f18c052f/smart-trashbox-trial/docs/inherited/hardware.md

# 手元にある部品と機材

> 旧リポジトリの部品表は「構成部品の表」であって、買ったかどうかは管理していなかった。
> 2026-09 時点で、足回りの部品と電子部品はすべて手元にあると記録されている。
> 念のため、トライアルを始める前に現物と照らし合わせること。
>
> 数値はメーカー資料・商品仕様・データシートの値である。
> 旧リポジトリで採寸した値は参考値として [reference-measurements.md](./reference-measurements.md) に分けて置いた。

## 1. 固定側

| 部品 | 型番・仕様 | 数量 | メモ |
|---|---|---|---|
| 深度カメラ | Intel **RealSense D435** | 1 | グローバルシャッターで速く動く物に強い。IMU は無い（カメラを固定するので不要） |
| 計算機 | **Raspberry Pi 4 Model B（4GB）** | 1 | セットアップ済み。→ [dev-environment.md](./dev-environment.md#3-raspberry-pi-4) |

## 2. 移動体: 駆動

| 部品 | 型番・仕様 | 数量 | メモ |
|---|---|---|---|
| ギアモータ | TOPINCN **JGB37-520** 12V / 530RPM / エンコーダ付き | 3 | 下の表 |
| モータブラケット | モータに付いてきた金属ブラケット | 3 | 別途買わなくてよい |
| オムニホイール | 60mm ダブルオムニ（Nexus **14145 相当品**） | 3 | **純正 Nexus 品ではない**。下の表 |
| ホイールハブ | 6mm ハブ（Nexus **18020**。純正か相当品かは未確認） | 3 | 下の表 |
| モータドライバ | 秋月電子 **AE-TB67H450**（東芝 TB67H450FNG） | 3 | モータ1個に1台 |
| MCU | **ESP32 DevKit（classic ESP32 / ESP32-WROOM-32）** | 2 | チップの刻印で classic ESP32 と確認済み。1台は予備（固定側で中継に使う案もある） |

### JGB37-520（商品仕様）

| 項目 | 値 |
|---|---|
| 電圧 | DC 12V |
| 無負荷回転数 / 定格回転数 | 530 RPM / 約 407 RPM |
| 減速比 | 約 19:1（公称。実際は割り切れない比のことが多い） |
| 定格トルク / 最大トルク | 約 2.2 / 約 3.1 kgf·cm |
| ストール電流 | 約 2.3 A |
| シャフト | 6mm D カット、長さ約 15.5mm |
| エンコーダ | ホール式、電源 3.3V / 5V、11 パルス/モータ1回転。出力軸1回転あたり約 209（11 × 約19）。**実際の値はカウント方法で変わるので測って決める** |
| 線 | 6本。赤・白 = モータ電源、青 = エンコーダ VCC、黒 = エンコーダ GND、黄・緑 = A相/B相（どちらが A 相かは仕様に書かれていない） |

⚠️ **黒はエンコーダの GND で、モータ電源の − は白である。**「黒＝GND」と思ってモータ電源を青・黒へ入れると、
エンコーダが壊れる。通電の前にテスターで系統を確かめる（→ [circuit-bringup.md](./circuit-bringup.md) の E-0）。

60mm ホイールでの理論周速: 無負荷 530RPM で約 1.66 m/s、定格 407RPM で約 1.28 m/s。
負荷・スリップ・電圧降下で実際はこれより遅くなる。

### オムニホイール（メーカー図面の値）

| 項目 | 値 |
|---|---|
| 外径 / 幅 | Ø60 / 25.6mm（**相当品なので現物は図面と違う**。旧リポジトリでの採寸は Ø57.9 / 23.4mm → [参考値](./reference-measurements.md#1-オムニホイールnexus-14145-相当品)） |
| 中心穴 | Ø12.5mm（ハブのボスを受ける穴。シャフトに直接は付かない） |
| ボルト円 | Ø21 と Ø28。取付穴 5-Ø3.2 / 6-Ø3（ハブと合うのは Ø21 側の 6-Ø3 を 120° おきに3本） |
| ローラー | 1枚に5個 × 2枚 = 10個、ナイロン / PE |
| 重さ / 耐荷重 | 80g / 3kg（1輪あたり） |

### ハブ（メーカー資料の値）

| 項目 | 値 |
|---|---|
| 内径 | Ø6、**真円**（D 形でもキー溝付きでもない） |
| フランジ外径 / 厚さ | Ø28 / 4mm |
| ボス | Ø12 × 12mm |
| 全長 | 16mm（シャフト 15.5mm とほぼ同じ長さなので、軸方向の調整代は無い） |
| ボルト円 | Ø21、3-Ø3.2 |
| 止めネジ | M4 × 1 |
| 重さ | 12g |

**つながり方**: モータの 6mm D シャフト → ハブ（加工なしで付く）→ ボスをホイールの Ø12.5 の穴へ入れてボルト円でネジ止め。
この組み合わせで組めることは現物で確認済み。

⚠️ **トルクを伝えるのは M4 のイモネジ1本だけ。** ハブの穴は真円なので、イモネジがシャフトの D カットの
平らな面に当たっていれば保持でき、丸い面に当たっていると滑る。
**滑ってもエンコーダはモータ側で回り続けるので、制御からは気付けない。** 組むときに平面へ当てる。

### AE-TB67H450（データシート・アプリケーションノートより）

| 項目 | 値 |
|---|---|
| 入力 | IN1 / IN2。H レベル 2.0〜5.5V なので ESP32 の 3.3V で動く。**内部に 100kΩ のプルダウンがある** |
| 真理値表 | (IN1, IN2) = (L, L) ストップ / (H, L) 正転 / (L, H) 逆転 / (H, H) ブレーキ |
| 論理電源 | 別のピンは無い（VM から内部で作る） |
| 端子 | 8本: GND / IN2 / IN1 / VREF / VM / OUT1 / RS / OUT2 |
| 過電流保護（ISD） | 標準 4.9A でラッチ。電源の入れ直しか、IN1/IN2 を 1ms 以上 L にしてから再指令で解除 |
| 熱 | 許容損失 2.85W（4層基板での値）。ストール 2.3A を流し続けると約 3.2W で超える |
| センス抵抗 | **モジュールには付いていない**（テスターで確認済み）。旧設計では付けないことにした（→ [circuit.md](./circuit.md#4-電流の守り)） |

ストール電流 2.3A はこのドライバの能力に近い。モータを長くストールさせないことをソフトの保護で担保する前提で選んだ。

## 3. 移動体: 電源と回路部品

| 部品 | 型番・仕様 | 数量 | メモ |
|---|---|---|---|
| バッテリ | BTLIPO **1500mAh 3S 35C XT60**（商品コード `BTLIPO1500mA3S35CXT60*C`） | 1 | 公称 11.1V / 満充電 12.6V |
| 充電器 | G-FORCE **G3 CHARGER**（G0018） | 1 | LiPo 1〜3S のバランス充電。1500mAh なら 1.5A 設定で約 1C |
| 電源コネクタ | **XT60M**（車体側） | 1 | |
| メインヒューズ | **10A** ＋ ヒューズホルダ | 1 | バッテリの XT60 のすぐ後ろ |
| 5V 電源 | ROHM **BP5293-50** | 1 | 入力 7〜26V、出力 5V ±3% / 最大 1A、SIP3 |
| 電解コンデンサ | Rubycon **ZLH 1000µF / 35V** | 2 | ドライバの近く |
| セラミックコンデンサ | **0.1µF / 50V X7R** | 一式 | モータ端子、ドライバの VM と VREF、ADC 入力 |
| 抵抗 | **100kΩ 1%** / **27kΩ 1%** | 一式 | バッテリ電圧を測る分圧 |
| 電源配線 | 14AWG など | 一式 | |
| ユニバーサル基板 | 秋月 **C タイプ 72 × 47.5mm**、片面 | 1 | 片面なので裏で配線を回せない |
| 配線の固定 | 布テープ、結束バンド | 一式 | |

**決まっていないもの**: メイン電源スイッチ（付けるか、どこに付けるか）、3台のドライバへ電源を分ける端子（要るか、どう分けるか）、
M3 ネジ・ナット・熱圧入インサートの数と長さ。

**注意**

- 1500mAh は容量であって、流せる最大電流ではない。35C から計算した 52.5A を実際に使える上限と考えない。
- 10A ヒューズは短絡や配線事故から LiPo と配線を守るもの。モータ1個のストール（約2.3A）では切れない。
  ストール 2.3A × 3 ≒ 6.9A に制御回路の分が乗るので、5A では急加速で切れるおそれがある。
- 充電器のバランス端子は JST-XH の想定。バッテリ側の形は現物で確かめる。

## 4. ゴミ箱

| 項目 | 内容 |
|---|---|
| 品名 | キャンドゥ「ダストボックス丸」＝ **山田化学 No.335**（JAN 4965534335027） |
| 仕様 | 丸型、PP、6.9L、フタなし、110円 |
| 買い直し | アスクルなどの通販で単品約160円。100円ショップは在庫が入れ替わると同じ品が手に入らなくなるので、こちらが当てになる |

⚠️ **パッケージの寸法表記（φ220 × H224）は実物と合わない。** φ220 は開口の外径である。旧リポジトリでの採寸値は [reference-measurements.md](./reference-measurements.md#4-ゴミ箱山田化学-no335) にある（参考値）。

選んだ基準（実店舗の品揃えを調べて決めた）:

- 丸型であること。角形は方向によって開口の広さが変わる。
- 開口の内径 φ200 以上。100円ショップの丸型は φ215〜225 あたりが上限で、φ240 以上は見つからなかった。
- 300g 以下。軽さが欲しいのは転倒対策ではなく加速のため。
- 高さ 200〜300mm（寝かせた空き缶が収まる深さ）。
- 脚付き・丸底は不可。ほぼ全品に入れ子用のテーパーがあるので、テーパーの緩いものを選ぶ。
- フタ・スイング・内枠は開口を狭めるので、無いものを選ぶ。
- 5L〜7L が狙い目。それより大きくしても径はほとんど変わらず、高さだけ伸びる。

## 5. 開発・検証用の機材

| 機材 | 状態 | 用途 |
|---|---|---|
| 3Dプリンタ **Bambu Lab A1 mini** | 手元にある | 造形範囲 180 × 180 × 180mm。囲いが無いので、使える材料は PETG までと考える |
| 開発用PC（Windows 11 + WSL2） | 手元にある | → [dev-environment.md](./dev-environment.md) |
| SONY **DualSense**（PS5 コントローラ） | 手元にある | 手動で走らせる（テレオペ）ため |
| テスター | 手元にある | 配線色の確認・電圧測定・ADC の校正 |
| ノギス | 手元にある | 採寸 |
| **安定化電源**（電流制限つき、12V / 3A 以上） | **手元にあるか要確認** | 最初の通電は必ずこれで行う。LiPo では初通電しない |
| 可変抵抗（10kΩ B カーブ程度） | **手元にあるか要確認** | 机上でモータ出力を連続的に変えて確かめる |
| LED 2色・抵抗 1kΩ | 用意する | モータの代わりにドライバ出力へ付ける治具（→ [circuit-bringup.md](./circuit-bringup.md#led-治具)） |

**まだ買わないもの**（要るかどうか確かめてから買う）: ゴミ箱内側の緩衝材、非常停止用の部品、
Raspberry Pi 5 / Jetson などの上位の計算機（Pi 4 で足りないと測って分かったときだけ考える）。
