f18c052f/smart-trashbox-trial/trials/01-circuit/notes.md

# 01 回路 — 記録

計画: [trial-plan.md の 01 回路](../../docs/trial-plan.md#01-回路)

## 置き場所

| 場所 | 内容 |
|---|---|
| [kicad/mobile-base/](./kicad/mobile-base/) | KiCad プロジェクト `mobile-base`。たたき台（[schematic-draft.html](../../docs/inherited/circuit/schematic-draft.html)）を元に、実物に合わせて起こす回路図。PCB は作らず、ユニバーサル基板で組む |

## 記録

（何をして、何が起きて、いくつだったか。日付ごとに書き足す）
