f18c052f/smart-trashbox-trial/docs/inherited/circuit/schematic-draft.html

配線図 たたき台 / 作図用

# 3輪オムニ足回り結線図

LiPo バッテリからモータドライバ3台・ESP32・エンコーダまでを、部品ごとの箱と端子名で描いた図です。 Cirkit Designer で本番の回路図を描くときの下敷きとして使ってください。 IN1 / IN2 の駆動方法は案B（ファーム側で直接駆動）に決着しました。 結線そのものは変わりませんが、線の意味が変わるため図2 の注記まで写してください。

部品は docs/bom.md 準拠 端子番号は kShippedPinPlan 準拠 MCU は classic ESP32（ESP32-WROOM-32） IN1/IN2 駆動 = 案B 決着済み 図1・2・2b・2c・3・4

## 図の読み方

配線は実際のハーネスの色でそのまま描いてあります。 赤 と 白 がモータの動力線、 青 と 黒 がエンコーダの電源とグランド、 黄 / 緑 がエンコーダのA相・B相です。 灰色は ESP32 からドライバへの制御信号、 橙は 5V 系です。

配線色の罠黒はグランドだが、モータ電源の負側は白である

このモータは 黒＝エンコーダの GND、白＝モータ電源の− です。 「黒＝共通グランド」と読んで 12V 系をエンコーダ対（青・黒）へ入れると、 エンコーダに電源電圧がそのまま掛かって即座に壊れます。 通電前にテスターで色と系統の対応を確かめてください。

## 電源をどう配るか

バッテリから 12V を1本のバスに立ち上げ、そこからドライバ3台と 5V DC/DC へ分けます。 ESP32 は 5V DC/DC から給電します。

図 1 電源系統 12V バスと接地

JP1 は 5V を切り離すためのジャンパです。 USB を挿して書き込む間は外し、実走行では挿します。BP5293 の 5V と PC の USB 5V が同じ線で並列になるのを防ぐためです。⚠️ 切るのは 5V の1本だけで、GND は常に繋いだままにしてください。

12V は1系統だけです。 バッテリの＋が F1 を通って VM という1本の赤いバスになり、そこから U1・U2・U3・U4 へ分かれます。図の赤い線はすべて同じ 12V です。

SW1 と TB1 は破線＝未決着です。 主電源スイッチと分岐端子の要否・方式は機構側の決定待ちなので、実線で描かないでください。

ESP32 の GND は細い線で GND-STAR まで戻しています。 近くの PGND へ繋がず、C1 のマイナス端子まで1本で引くのが要点です（理由は図4）。

エンコーダの4線はこの図には出てきません。 モータ1個ぶんの詳細は図2 を見てください。

## モータ1個ぶんの結線

輪0 を例に、ESP32 ・ モータドライバ ・ モータ＋エンコーダの6線をすべて描いたものです。 輪1・輪2 もまったく同じ形で、GPIO 番号だけが下の表のとおり変わります。

図 2 輪0：ESP32 ─ ドライバ ─ モータ／エンコーダ 輪1・輪2 も同一構成

モータから出ている線は全部で6本です。 太い2本（赤・白）がドライバからの動力、細い4本（青・黒・黄・緑）がエンコーダです。系統がまったく別なので、束ねるときも分けてください。

黄と緑は破線で描いています。 メーカーの記載でも両方とも「信号線」としか書かれておらず、どちらが A相 かは資料を探しても載っていません。実測でしか決まらないので、確定するまで「確定した色」として描かないでください。

VREF と RS はこの図では省いています。 8端子すべての接続は図2bを見てください。VM−GND 直近の 0.1µF セラミックも図2b にあります。

⚠️ 赤と白はどちらも「出力」です。 白は「モータ電源−」という名前ですが H ブリッジの出力端子（OUT2）であり、GND ではありません。逆転中は白に 12V が出ます。 ここへエンコーダの黒を繋ぐとエンコーダが即死します。

案B にしても線は1本も動きません。 GPIO19→IN1、GPIO23→IN2 のままです。変わるのは線の意味だけで、「PWM線と方向線」ではなく「前進時に振る線と後進時に振る線」になります。この注記を省くと図が案B前と区別できなくなります。

輪ごとの GPIO 割当（図2 の4本が輪ごとに変わる）／ 案B 反映済み
輪 | IN1 ← 前進 PWM kMotorPwm | IN2 ← 後進 PWM kMotorDir | A相 ← 黄/緑 | B相 ← 緑/黄
輪0（図2 の例） | GPIO19 | GPIO23 | GPIO4 | GPIO13
輪1 | GPIO21 | GPIO25 | GPIO14 | GPIO16
輪2 | GPIO22 | GPIO26 | GPIO17 | GPIO18

決着IN1 / IN2 の駆動は案B — ファーム側を直接駆動へ変える

TB67H450 は IN1 と IN2 の組み合わせで動作が決まる IC です （L,L=ストップ ／ H,L=正転 ／ L,H=逆転 ／ H,H=ブレーキ）。 いっぽう従来のファームは「PWM 1本＋方向レベル 1本」を出していたため、 素直に繋ぐと前進・指令ゼロで全速逆転していました。 これを、どちらの線に PWM を載せるかで方向を表す方式へ改めます。

案B の出し方（これを図に注記として書く）
指令 | IN1 | IN2 | モータ
前進 | PWM | L | 正転。PWM の Low 期間はコースト
後進 | L | PWM | 逆転。減衰のしかたは前進と同じ
ゼロ指令 | L | L | ストップ 出力オフ

配線は1本も変わりません。 GPIO19→IN1、GPIO23→IN2 のままで、 追加部品もゼロです（案A の 74HC00 ×3 が要らない）。 前進と後進で減衰の効き方が揃うため、あとで速度制御を載せたときに 方向によって挙動が変わることもありません。

図の側でやることは注記だけです。 配線が変わらないぶん、注記が案B を表現する唯一の手段になります。 図2 の「IN1 ← 前進時に PWM／IN2 ← 後進時に PWM」と、上の表を必ず写してください。 これを省くと、図は案B 前とまったく同じ絵になります。

✅ データシートとアプリケーションノートで裏付けが取れました。 上の真理値表はデータシート p.6 のとおりです。さらにアプリケーションノートには 「4. ダイレクト PWM 制御」という章が独立してあり、 「IN1、IN2 端子に PWM 信号を入力して PWM 動作させることにより速度制御が可能」と明記されています。 案B は許容される使い方ではなく、メーカーが想定している使い方でした。

同じ章が「定電流機能を無効にする場合は RS 端子を GND に接続し、VREF 端子には 1〜5V を入力」 とも述べています。本図はこの構成を採り、電流検出抵抗を入れません （理由は「電流の守りをどこでかけるか」を参照）。

⚠️ ゼロ指令 (L,L) が 1ms 続くとスタンバイに入りますが、復帰は最大 30µs です。 制御周期 100〜200Hz（5〜10ms）に対しては無視できます。 また IN1 / IN2 には内部 100kΩ プルダウンがあるため、ESP32 が未駆動のときは 自動的に (L,L) = ストップになります。

## ドライバ1個ぶんの全端子（VREF / RS を含む）

図2 では省いていた VREF（電流設定）と RS（電流検出）を含む、 8端子すべての接続です。アプリケーションノート 表7-1 / 表7-2 の推奨値に合わせてあります。 輪1・輪2 もまったく同じ形で、IN1 / IN2 の GPIO 番号だけが変わります。

図 2b U1（AE-TB67H450）の8端子 U2・U3 も同一構成

0.1µF セラミックは 1000µF 電解の代わりではありません。 電解は高い周波数ではインダクタンスが効いて応答できず、スイッチングのエッジを受け持つのはセラミックのほうです。アプリケーションノート 表7-1 が VM−GND 間に両方を挙げているのはこのためです。

0.1µF は IC のすぐ横に置いてください。 間に配線が入ると、インダクタンスぶんだけノイズ抑制が効かなくなります。

RS は GND へ直結し、電流検出抵抗は入れません。 データシート p.10 が「定電流制御機能を無効にしたい場合は、RS 端子を GND に接続し、VREF 端子に 1〜5V を入力してください」と定める構成です。電流の守りは安定化電源の電流制限でかけます（理由は下の節）。

U1〜U3 の端子接続（アプリケーションノート 7.1 / 7.3 / 7.4 準拠）
# | 端子 | 接続先 | 備考

1 | GND | PGND → GND-STAR | 動力側。IN1/IN2 の論理基準もここ
2 | IN2 | ESP32 GPIO23 / 25 / 26 | 後進時に PWM。内部 100kΩ プルダウンあり
3 | IN1 | ESP32 GPIO19 / 21 / 22 | 前進時に PWM。同上
4 | VREF | ESP32 3V3（3.3V）＋ 0.1µF → GND | 無効化のための印加（1〜5V）。絶対最大 5.5V
5 | VM | 12V バス ＋ 0.1µF → GND | 動作範囲 4.5〜44V
6 | OUT1 | モータ 赤 | 出力 GND ではない
7 | RS | GND へ直結 | 定電流制御を無効にする（データシート p.10）
8 | OUT2 | モータ 白 | 出力 逆転中は 12V

⚠️ モジュールにセンス抵抗が実装済みでないか、現物で確認してください。 無通電で RS 端子と GND 端子の間をテスターで測り、0.2Ω前後なら実装済み（外付けは不要）、 開放なら未実装です。実装済みのところへ重ねて付けてはいけません。

## 電流の守りをどこでかけるか

前置きデータシートは電流制限を要求していない

制限しない構成が正式に認められています。 「定電流制御機能を無効にしたい場合は、RS 端子を GND に接続し、VREF 端子に 1〜5V を 入力してください」（データシート p.10 ／ アプリケーションノート 4.1）。 本図はこの構成を採ります。電流検出抵抗は入れません。

### 守りは安定化電源の電流制限（CC）でかける

机上の確認はすべて電流制限のかけられる安定化電源で行います。 電源側の CC を 1.5A に設定しておけば、それがそのまま電流制限として効きます。 IC にそれを超える電流は物理的に流れません。 電流検出抵抗がやろうとしていた仕事を、電源がすでにやっています。

段ごとの守り
段 | 電源 | 守り
机上の全段（通電確認 〜 3輪を浮かせて回す） | 安定化電源 | 電源の電流制限 1.5A
接地走行以降 | LiPo | ⚠️ 電流制限が無い。 ソフトのモータロック保護が本来の守りになる

### なぜ抵抗を入れないほうがよいのか

入手しやすい 1Ω を1本入れると、上限は (1/10) × 3.3V ÷ 1Ω = 0.33A になります。 ストール 2.3A に対してトルクが約8%で、最大出力点（約 1.15A）の 1/3 以下です。 これでは走りません。

⚠️ さらに、その上限では定電流チョッパがほぼ常時働きます。 固定OFF時間 25µs が割り込むため、デューティと実際の出力の関係が崩れます。 開ループ確認の合格条件は「全域で滑らかに加減速する」ですが、 チョッパが常時介入していると、それが素の挙動なのか制限が効いているのか 区別できません。抵抗を入れないほうが、見たいものが見えます。

🔶 推奨値の 0.22Ω なら上限 1.5A になりますが、入手しづらい値です。 1Ω を4本並列（0.25Ω / 1.32A）でも作れますが、電源側で同じ守りがかかる以上、 わざわざ部品を増やす理由がありません。

### ⚠️ IC の発熱について知っておくこと

ストール電流 2.3A を連続で流すと、IC の損失が許容損失を超えます。

条件 | IC の損失 | 許容損失 2.85W に対して
ストール 2.3A（Ron 0.6Ω 標準） | 3.17 W | 超える。Ron 最大 0.8Ω なら 4.23W
電源制限 1.5A（Ron 0.6Ω 標準） | 1.35 W | 余裕あり

⚠️ この計算には前提が2つあります。 ひとつは「連続で」2.3A が流れることで、一瞬のストール（数十〜数百 ms）なら 熱容量が吸収します。もうひとつは許容損失 2.85W が4層基板の値であることで、 秋月のモジュール（2層）ではこれより小さくなります。 さらにデータシート自身は注1 で 2.45A までを目安として許容しており、 PD 2.85W とは緊張関係にあります。

机上の段では、電源の電流制限 1.5A がこれを抑えます。 LiPo へ移る前に、ソフトのモータロック保護が働くことを確かめてください。 ⚠️ 逃げ道の TSD はデータシートが「積極的に活用するような使用方法は避けてください」と 明記しており、頼る対象ではありません。

保護は3段構え（電流検出抵抗を入れない場合）
段 | 働くところ | 解除のしかた
電源の電流制限（机上） | 設定値で頭打ちになる。電圧が垂れるので目で分かる | —
ソフトのモータロック保護 | ストールが一定時間続いたら停止 | ファームの判断
ISD（過電流 4.9A 標準・ラッチ） | 短絡など異常時 | 電源再投入、または IN1/IN2 を 1ms 以上 L にしてから再指令
TSD（150〜175℃・自動復帰） | 最後の砦 | ⚠️ 積極的に活用してはいけない

ISD はファームから解除できます。 案Bのゼロ指令 (L,L) を 1ms 以上保持してから 指令を再開するだけです。モータロック保護の復帰を自動にするか手動にするかを決めるときの材料になります。

## 電源を入れる順序

手順VM を入れる前に、ESP32 の IN1 / IN2 を L にしておく

アプリケーションノートの指示です（1.2 / 3章）。

- VM 電圧が不安定な立ち上げ／立ち下げの途中は、モータ動作を OFF にしておく
- 電源投入前は入力信号も Low レベルにしておく

⚠️ これは開ループ確認に直撃します。 USB で ESP32 だけ生かしたまま（VM オフ） IN1 / IN2 が振られている状態で主電源を入れると、入れた瞬間にモータが動きます。 手順として「VM を入れる前に ESP32 をリセットする」を挟んでください。

救いとして、IN1 / IN2 には内部 100kΩ プルダウンがあります。ESP32 がリセット中で 端子がハイインピーダンスなら、自動的に L に落ちてストップになります。

## USB を挿すときは JP1 を外す

開ループ確認では USB で書き込みながら、ログを見ながら、モータを回します。 このとき USB の 5V と BP5293 の 5V が同じ線に並列でぶら下がると、 電圧の高いほうが低いほうへ流し込みます。 PC の USB ポートへ逆流するか、BP5293 の出力へ逆流するかのどちらかです。 降圧コンバータは出力側から電流が入ることを想定していません。

JP1 の運用
場面 | JP1 | 5V の供給元
書き込み・ログ確認（USB あり） | 外す | USB のみ
実走行（USB なし） | 挿す | BP5293-50 のみ

⚠️ 切るのは 5V の1本だけです。GND は常に繋いだままにしてください。 切ってしまうと、ドライバの論理基準と ESP32 の基準が別物になります。

モータの 12V は BP5293 とは別系統なので、JP1 を外しても USB 給電のまま普通にモータが回せます。 DevKit の 5V ピンが USB の VBUS と直結かダイオード経由かは基板の版によって違いますが、 JP1 を入れておけばどちらであっても問題が起きません。

## エンコーダのプルアップ（置き場所だけ確保しておく）

エンコーダの出力がオープンコレクタかどうかが未確認で、ESP32 の内部プルアップが 効くかも版に依存します。いまは実装しませんが、基板上の位置だけ空けておけば、 実測で必要とわかったときに図を描き直さずに済みます。

図 2c エンコーダ A相 / B相 の外付けプルアップ（予備位置） 未実装 ・ 輪0 を例示

いま付けてはいけない、という意味ではありません。 「必要かどうかが未確認なので、確定したように実線で描かない」という意味です。実測で要ると決まったら、破線を実線に変えるだけで済みます。

## ESP32 から出る信号線は全部で14本

kShippedPinPlan が定める14本がこれで全部です。 図を描き終えたら、この表と1本ずつ突き合わせてください。 「表にあるのに図に無い」だけでなく、「図にあるのに表に無い」も同じように探します。 片側だけ見ると、余分な結線が図に残っていても気づけません。

端子割当の全量（kShippedPinPlan 14件）
# | GPIO | PinRole | 行き先 | 図

1 | 19 | kMotorPwm w0 | U1 IN1（前進時 PWM） | 2
2 | 23 | kMotorDir w0 | U1 IN2（後進時 PWM） | 2
3 | 21 | kMotorPwm w1 | U2 IN1（前進時 PWM） | 2
4 | 25 | kMotorDir w1 | U2 IN2（後進時 PWM） | 2
5 | 22 | kMotorPwm w2 | U3 IN1（前進時 PWM） | 2
6 | 26 | kMotorDir w2 | U3 IN2（後進時 PWM） | 2
7 | 4 | kEncoderA w0 | M0 エンコーダ A相 色 未確定 | 2・2c
8 | 13 | kEncoderB w0 | M0 エンコーダ B相 色 未確定 | 2・2c
9 | 14 | kEncoderA w1 | M1 エンコーダ A相 色 未確定 | 2
10 | 16 | kEncoderB w1 | M1 エンコーダ B相 色 未確定 | 2
11 | 17 | kEncoderA w2 | M2 エンコーダ A相 色 未確定 | 2
12 | 18 | kEncoderB w2 | M2 エンコーダ B相 色 未確定 | 2
13 | 32 | kBatterySense | R1 / R2 の中点（分圧） | 3
14 | 33 | kBenchPot | VR1 ワイパ（机上確認の仮設） | 3

このほかに電源系として 3V3 ・ GND ・ VIN(5V) を使いますが、 これらは端子割当の管理対象ではありません（図1・図2 を参照）。

## バッテリ電圧の監視と、机上確認用のつまみ

12V をそのまま ESP32 へ入れると壊れるので、抵抗2本で 1/5 弱に分けてから読みます。 あわせて、開ループ確認のときに手で出力を変えるための可変抵抗も描いています。

図 3 電圧監視の分圧回路と机上確認用可変抵抗 VR1 は仮設

R1 の上は「ヒューズより後ろの 12V バス」に繋ぎます。 知りたいのはドライバが実際に受けている電圧（加速時の落ち込みを含む）だからです。主電源スイッチが決まったら、その後ろに入れてください。電源を切ったときにバッテリを舐め続けなくなります。

## 接地の引き回し

これは配線表では表せない、回路図でしか示せない部分です。 判断のしかたは1つだけです。

見分け方エンコーダの黒から ESP32 の GND ピンまで、指でたどってみる

その経路にモータ電流が流れる区間があるか。あれば間違いです。

エンコーダは A相 / B相 を「自分の黒を 0V として」出します。 ESP32 はそれを「自分の GND を 0V として」読みます。 この2つの 0V がずれれば、そのずれがそのまま信号に足し算されます。 黒から ESP32 の GND までの経路にエンコーダ自身の消費電流（十数 mA）しか流れていなければ、 ずれようがありません。

⚠️ 効くのは電圧差よりスパイクのほうです。 配線と端子で 20mΩ、6.9A 流れても 138mV 程度で、ESP32 のロジックしきい値には余裕があります。 危ないのは PWM が切り替わる瞬間で、配線のインダクタンス（20cm で約 200nH）に L·di/dt の電圧が立ちます。1A/µs なら 0.2V。 エンコーダの計数はエッジを数えているので、スパイク1発がパルス1個の誤カウントになります。 壊れるのではなく静かに数え間違える故障なので、たちが悪いほうです。

モータの電流は最大で 2.3A × 3 ＝ 約 6.9A 流れます。 この電流が通る線に ESP32 のグランドをぶら下げると、線の抵抗で生じた電圧が そのまま ESP32 の基準電位の揺れになります。

図 4 接地：星形1点で合流させる 左が正・右が誤り

合流点は図の上で1箇所だけにしてください。 2箇所以上で繋がると接地ループになります。GND-STAR から出ている線が何本で、どれが動力側でどれが信号側かが数えられるように描くのがコツです。

ドライバの GND は動力側です。 AE-TB67H450 は GND ピンが1本しかなく、IN1 / IN2 の基準もその GND なので、動力側として扱います。

⚠️ 「黒と白がつながる」ではありません。 接地でつながるのは エンコーダ黒 ─ ESP32 GND ─ ドライバの GND 端子(pin1) ─ C1/C2 の − ─ バッテリ − です。白（OUT2）はこの仲間ではありません。 H ブリッジの出力なので、逆転中は 12V が出ています。

実際の配線でいうと、エンコーダの黒は ESP32 の GND ピンへ挿し、ESP32 の GND から GND-STAR へ1本引きます。避けるべきはドライバの GND 端子に黒を共締めすること、太い動力線の途中に割り込ませることです。

## 図に出てくる部品

型番は docs/bom.md の構成部品一覧のとおりです。図では記号（BT1・U1 など）だけを書き、値はこの表で引く形にしています。

記号 | 部品 | 型番・値 | 個数 | 図
BT1 | バッテリ | BTLIPO 1500mAh 3S 35C XT60 | 1 | 1
F1 | メインヒューズ | 10A ＋ ヒューズホルダ | 1 | 1
SW1 | 主電源スイッチ | 未決着 | 1 | 1
TB1 | 電源分岐端子 | 未決着 | — | 1
U1–U3 | モータドライバ | 秋月 AE-TB67H450 | 3 | 1・2
U4 | 5V DC/DC | ROHM BP5293-50 入力 7〜26V ／ 出力 5V±3% 1A ／ 570kHz | 1 | 1
M0–M2 | ギアモータ（エンコーダ付） | JGB37-520 12V / 530RPM | 3 | 1・2
C1, C2 | 電解コンデンサ | Rubycon ZLH 1000µF / 35V | 2 | 1
C3–C5 | セラミックコンデンサ | 0.1µF / 50V X7R モータ1個につき 赤−白 間に1個 | 3 | 2
C6 | セラミックコンデンサ | 0.1µF / 50V X7R | 1 | 3
C7–C9 | セラミックコンデンサ 追加 | 0.1µF / 50V X7R 各ドライバの VM−GND 直近 | 3 | 2b
C10–C12 | セラミックコンデンサ 追加 | 0.1µF / 50V X7R 各ドライバの VREF−GND 直近 | 3 | 2b
JP1 | 5V 切り離しジャンパ 追加 | 2ピンヘッダ ＋ ジャンパピン | 1 | 1
R1 | 抵抗（分圧・上側） | 100kΩ 1% | 1 | 3
R2 | 抵抗（分圧・下側） | 27kΩ 1% | 1 | 3
VR1 | 可変抵抗（仮設） | 机上確認用 | 1 | 3
R3–R8 | プルアップ抵抗 未実装 | 10kΩ（置き場所のみ確保） | (6) | 2c
— | MCU | ESP32 DevKit | 1 | 1–3

## コンデンサは「どこに置くか」まで図に書く

これらは接続先が合っていても、置き場所を外すと効きません。図の上に位置の指示として書いてください。

記号 | 接続 | 置き場所 | 理由
C3–C5 | 各モータの 赤 − 白 の間 | モータ本体の端子に直付け。ドライバ側の端子台ではない | 抑えたいのはブラシのノイズ。発生源で閉じ込めないと動力線の全長がアンテナとして残る
C1 | VM − GND-STAR | 分岐の入口側。このマイナス端子が GND-STAR を兼ねる | モータ電流の戻りが最も落ち着く点だから。入口／奥に分ける分散のしかたは本図の提案で、出典は「ドライバ付近に、必要に応じて2個を分散」としか述べていない
C2 | VM − PGND | いちばん奥のドライバ（U3）の VM / GND 端子の直近 | VM と GND のループ面積を小さくしないとスイッチング時に電圧スパイクが出る
C6 | GPIO32 − SGND | ESP32 の GPIO32 ピンの直近。抵抗側の端ではない | 分圧の合成抵抗が約 21kΩ と高く、ADC が読む瞬間の電荷を供給するのが C6 だから
C7–C9 | 各ドライバの VM − GND | IC のすぐ横 | 1000µF 電解は高い周波数ではインダクタンスが効いて応答できない。スイッチングのエッジを受け持つのはセラミックのほう（アプリケーションノート 表7-1）

## 向きを間違えると壊れるもの／テスターを当てる場所

極性があるもの
記号 | 向き | 間違えたときに起きること
C1, C2 | ＋ を VM 側、− を PGND 側 | 破裂・発火 12V を逆極性で受ける。本機でいちばん危険
U4 | Vin / GND / Vout のピン配置 | 逆接で DC/DC が壊れ、5V が出なくなる
U1–U3 | VM / GND の端子並び | 逆接でドライバが壊れる
M0–M2 | 赤 / 白 | 回転方向が逆になるだけ。壊れない（対応はモータ単体確認で決める）

電圧測定点（TP1〜TP7 はすべて図の上に記号で置いてある）
TP | どこ | 基準 | 期待値
TP1 | F1 の出口（VM バス） | GND-STAR | 11.1 – 12.6V
TP2 | U4 の 5V 出力 | GND-STAR | 5.0V ±5%
TP3 | ESP32 の 3V3 ピン | SGND | 3.3V ±5%
TP4 | 分圧の中点（GPIO32） | SGND | 3.3V 未満（12.6V で約 2.68V）
TP5 | エンコーダコネクタの 青 | 黒 | 3.3V ／ 12V なら即中止
TP6 | U1–U3 の VM 端子 | GND-STAR | TP1 と同じ（差 0.2V 未満）
TP7 | U1 の GND 端子 | SGND | 無負荷で約 0V

TP4 と TP5 は 繋ぐ前に測る ものです。TP4 が 3.3V を超えていれば GPIO32 が壊れ、 TP5 に 12V が出ていればエンコーダが壊れます。

## まだ決まっていないので、確定したように描かないところ

項目 | 図での描き方 | いつ決まるか
エンコーダ A相 / B相 の線色（黄か緑か） | 破線 ＋「未確定」と併記（図2） | 輪単体の実測で確定
主電源スイッチ SW1 | 破線の箱（図1）。作図ツールで具体的な部品を置くときは「暫定・機構側未決着」と明記する | 機構側の決定待ち（OQ-11）
電源分岐端子 TB1 | 同上。WAGO 等を置く場合も暫定扱い | 機構側の決定待ち（OQ-12）
OUT1 / OUT2 と 赤 / 白 の対応 | 「仮」と注記（図2） | モータ単体で回して確定
エンコーダの外付けプルアップ | 図2c に破線・未実装の予備位置として置いた。実線にしない | 通電後の実測

## この図で決めたこと（出典ではなく、本図の判断）

以下は docs/ の文書に書かれておらず、この図を描くために決めたものです。 出典からの転記ではないので、違う結論にしたければ変えて構いません。

決めたこと | 採った案 | ほかの案を採るとどうなるか
IN1 / IN2 の駆動方法 | 案B（ファーム側で IN1/IN2 を直接駆動） | 案A なら 74HC00 ×3 とプルダウンが増え、ESP32 とドライバの間に段が1つ入る
0.1µF セラミック C3–C5 の個数 | 3個（モータ1個につき 赤−白 間に1個） | 「端子1本につき1個を筐体へ落とす」解釈なら6個になり、筐体アースの扱いを別に決める必要が出る
1000µF 2個の分散のしかた | 入口（C1）と奥のドライバ直近（C2） | 出典は「ドライバ付近に必要に応じて2個」としか言っていない。2個まとめて置く案もある
電流の守りをどこでかけるか | IC では制限しない（RS→GND 直結）。守りは安定化電源の電流制限 1.5A | 0.22Ω を入れれば IC 側で 1.5A に制限できるが入手しづらい。1Ω 1本では 0.33A になり走らない。4本並列（0.25Ω）でも作れるが、電源側で同じ守りがかかる以上わざわざ部品を増やす理由がない。⚠️ LiPo へ移る前に再考すること
エンコーダのプルアップ | 破線・未実装で位置だけ確保（図2c） | 置かない案もある。その場合、実測で必要とわかった時点で図を描き直す
USB と 5V の同時接続をどう避けるか | JP1（5V 切り離しジャンパ）を入れる | DevKit の版ごとに USB VBUS と 5V ピンの繋がり方を調べる手もあるが、版が変わるたびに調べ直しになる
GND-STAR をどこに置くか | C1（1000µF）のマイナス端子 | バルクコンデンサの直近がモータ電流の戻りが最も落ち着く点。別の点にするなら理由が要る

## 作図の前に現物・データシートで確かめること

ここから先は現物とデータシートを見ないと決まりません。 図に載る値や要素が変わるので、描き始める前に潰しておくと描き直しになりません。

データシート／アプリケーションノートで解決した項目
項目 | 結果
TB67H450 の真理値表 | ✅ 想定どおり。案B はメーカーが想定する「ダイレクト PWM 制御」そのものでした
電流制限（VREF / RS）の設定方法 | ✅ RS→GND 直結で無効化し、VREF へ 3.3V。守りは電源の電流制限（図2b）
論理用の電源ピンが別にあるか | ✅ IC には無い（VM のみ）。内部に VCC レギュレータを持つ
ロジック入力の電圧範囲 | ✅ VIN(H) 2.0〜5.5V。3.3V で問題なし。内部 100kΩ プルダウンあり
モジュールのセンス抵抗 | ✅ 未実装（実測で確定）。RS−GND を 2000Ω レンジで測って片方向 465Ω、逆向きで OL。向きで値が変わるので抵抗ではなく IC 内部の半導体接合。⚠️ ただし外付けもしない方針に決着した
BP5293-50 の定格 | ✅ 入力 7〜26V（3S LiPo の 9.0〜12.6V は内側）、出力 5V 1A（必要なピークは約300mA で3倍以上の余裕）
USB と VIN の同時接続 | ✅ JP1 で 5V を切り離すことにした。基板の版に依存しなくなる

- 図の MCU が classic ESP32（ESP32-WROOM-32）であること — ⚠️ ESP32-S3 では GPIO22/23/24/25 が存在せず、32/33 も使えません。 さらに S3 には Bluetooth Classic がなく（BLE のみ）、テレオペの第一候補が成立しません。platformio.ini は board = esp32dev です。
- 「各モータ端子の直近に1個ずつ」の解釈 — 上の表のとおり3個で描いてあります。意図が「端子1本につき1個」だったなら6個へ増やしてください。

⚠️ モジュールは素通しのブレークアウトです。 センス抵抗すら載っていないため、 VM−GND のセラミック（C7〜C9）も載っていない可能性が高いです。ただし セラミックは並列に足しても害がない（容量が増えるだけ）ので、迷ったら付けてください。 センス抵抗と違い、既存品と並列になって電流上限が変わるようなことは起きません。

## Cirkit Designer で描くときの順序

この図をそのまま写すときの手順です。電源から描き、信号は最後にしてください。 接地の分け方が先に決まっていないと、あとから直すのが最も面倒になります。

1. 電源系（図1） — BT1 → F1 → VM バス → U1・U2・U3・U4。SW1 と TB1 は破線の箱のまま、実線で繋がない。
2. 接地（図4） — PGND と SGND を分け、合流は GND-STAR の1点だけ。C1 のマイナス端子を星の中心にする。
3. 電解コンデンサの向き — C1・C2 の ＋ を VM 側に、記号で極性がわかる形で置く。本機でいちばん危険な部品です。
4. モータ1個ぶん（図2 と 図2b）を描いて、3回複製 — GPIO 番号だけを14本表のとおり差し替える。
5. ドライバの8端子を全部繋ぐ（図2b） — VREF→3.3V、RS→GND へ直結、VM−GND 直近に 0.1µF。⚠️ 0.1µF は IC のすぐ横に置くこと。
6. 案B の注記を書く — 「IN1 ← 前進時に PWM／IN2 ← 後進時に PWM」と真理値表。これを省くと図が案B 前と区別できません。
7. 電圧監視（図3） — R1 の上端は BAT+ ではなく VM（ヒューズより後ろ）。C6 は GPIO32 ピンの直近。
8. ノイズ対策部品に置き場所の文字を添える — C3–C5「モータ本体端子に直付け」、C6「GPIO32 直近」、C1/C2「VM−GND ループ最小」。接続先だけでは足りません。
9. TP1〜TP7 を記号で置き、期待値を併記する — 手順書が「どこを測るか」を文章で説明せずに済むようにするためです。
10. 未確定・未決着の表示を入れる — 黄/緑、OUT1/OUT2 と赤/白、SW1、TB1、プルアップ。確定値として描かないこと。
11. MCU が classic ESP32（ESP32-WROOM-32）であることを確かめる — ⚠️ ESP32-S3 では GPIO22/23/24/25 が存在せず、32/33 も使えません。部品を置く前に確認してください。
12. 14本表と1本ずつ突き合わせる — 「表にあるのに図に無い」と「図にあるのに表に無い」の両方向を見る。
13. 電源投入の順序を注記する — 「VM を入れる前に ESP32 をリセットする」。入れた瞬間にモータが動くのを防ぐためです。
