f18c052f/smart-trashbox-trial/docs/inherited/reference-measurements.md

# 旧リポジトリでの採寸値（参考値）

旧リポジトリで手元の部品をノギスなどで測った値。**参考値として**残す。

- **合否条件や設計の確定値にしない。** トライアルで使う部品は現物で測り直し、食い違ったらそちらを正とする。
- 手で測った値で、誤差があることは測った時点で承知していた。
- 「導出」と書いた値は、測った値から計算したものである。測ってはいない。
- メーカーの公表値は [hardware.md](./hardware.md) にある。公表値と食い違う値は、ここではそのことを書いた。

## 1. オムニホイール（Nexus 14145 相当品）

| 項目 | 値 | 測った日 | メモ |
|---|---|---|---|
| 外径 | Ø57.9mm | 2026-09-10 | 図面値 Ø60 より 2.1mm 小さい（相当品のため） |
| 幅 | 23.4mm | 2026-09-10 | 図面値 25.6mm より 2.2mm 狭い |
| 車軸中心の高さ（床から） | 28.95mm | — | 導出（外径の半分）。荷重でローラーが潰れる分は入っていない |

荷重をかけたときの実効の転がり径は測っていない。オドメトリと予測の両方に効くので、トライアル 03 で測る。

## 2. 駆動ユニット

### 付属の金属ブラケット

| 項目 | 値 | 測った日 | メモ |
|---|---|---|---|
| 外形 | 43.1 × 40mm | 2026-09-10 | モータ軸方向に長い L 字。2026-09-03 に目で見て記した「41.3 × 38.8mm」は誤りだった |
| 取付穴 | 4つ、長方形に並ぶ | 2026-09-10 | |
| 取付穴の中心距離 | 22.9mm（モータ軸方向）× 29.6mm（接線方向） | 2026-09-10 | 向きはノギスを当てた写真で確定 |
| 取付穴の径 | 約 2.7mm（手で測った値） | — | M3 は通る。設計では呼び径 3.2mm として扱っていた |
| 取付フランジの厚さ | 3.2mm | 2026-09-14 | 角が丸みを帯びていて、一点の値が厚さを代表しない。旧設計はこの値を使わず、上限 6.0mm でボルト長を決めた |
| 取付面 → 接地点（鉛直） | 60.0mm | 2026-09-03 | 駆動ベースの板の下面を床から何 mm に置くかを決める値 |
| 取付面 → ホイール中心 | 33.9mm | 2026-09-03 | **軸方向に測ったかは確かめていない**（下記） |
| 取付面 → ブラケットの最下点（鉛直方向の張り出し） | 40.2mm | 2026-09-14 | **床からの高さではない**（下記） |
| ブラケットの最下点（床から） | 19.8mm | — | 導出（60.0 − 40.2）。車軸中心より 9.15mm 下なので、ブラケットはモータ胴体を中心より下まで抱えている |

- **33.9mm の向き**: 取付面 → 接地点 60.0 と同じく鉛直に測ったのだとすると、差の 26.1mm がホイール半径（約 30mm）と合わない。
  そのため軸方向に測った値と読んだ。ただし、これは整合から推した結論で、測った向きを直接確かめてはいない。
- **40.2mm の取り違え**: 測り方の手引きが「床からブラケットの一番低いところまで」と誤って指示していたため、一度床からの高さとして読んだ。
  実際に測ったのは取付面からの距離である。測り方の指示が誤っていると、返ってくるのは「誤った値」ではなく「別の量の正しい値」になる。
  測り直すときは、どこからどこまでを測るかを図に描いてから測る。
- 2026-09-03 に別途 105.6mm という値があったが、どこを基準に測ったか分からないので捨てた。

### モータ・ハブ・ホイールの積み重なり

| 項目 | 値 | メモ |
|---|---|---|
| ホイール外面 → モータの最後端 | 93.3mm | 測った値（2026-09-10）。組んだ状態で測った |
| モータ全長（ギヤボックス端面から後端まで、端子の突起を含む） | 65.9mm | 導出（93.3 − ホイール幅 23.4 − ハブのフランジ厚 4.0） |
| ギヤボックス端面 → ホイール内側面 | 4mm | ハブのフランジ厚（メーカー値） |
| ギヤボックス端面 → ホイール中心面 | 15.7mm | 導出（4 + 23.4 / 2）。2026-09-10 に現物で確かめた |
| ギヤボックス端面 → ホイール外側面 | 27.4mm | 導出（4 + 23.4） |

- イモネジがシャフトの D カットの平面に当たっているかは確かめていない（丸い面に当たると滑る）。

## 3. 電子部品・電源

| 部品 | 項目 | 値 | 測った日 | メモ |
|---|---|---|---|---|
| モータドライバ AE-TB67H450 | 基板の外形 | 22.3 × 12.3mm | 2026-09-14 | ピンの数から 20.32 × 15.24mm と推定していたが、2辺とも外れていた |
| 3S LiPo 1500mAh | 外形 | 77.8 × 32.5 × 23.2mm | — | |
| 3S LiPo 1500mAh | 重さ | 121g | — | |
| モータの配線 | 1輪ぶんの束の太さ | 8.0mm | — | 床から浮かせる高さや通し穴の大きさの目安 |

### モータの配線の抵抗（無通電、テスター）

E-0（[circuit-bringup.md](./circuit-bringup.md)）で測った値。2026-10-03、合格。

| 測ったところ | 値 | 読み方 |
|---|---|---|
| 赤 − 白（モータ電源） | 数Ω | モータの巻線 |
| 青 − 黒（エンコーダの電源） | 1547Ω | 短絡でも巻線でもない。無通電のホール素子 IC の内部回路をテスターが拾った値と判断した。赤・白とは別系統である |
| 赤 − 青 / 黒 / 黄 / 緑 | すべて開放 | |

## 4. ゴミ箱（山田化学 No.335）

| 項目 | 値 | メモ |
|---|---|---|
| 開口の内径 | Ø210mm | 縁の巻き込みの内側で測った。パッケージの φ220 は外径 |
| 上端の外径 | Ø220mm | |
| 底の外径 | Ø180mm | |
| 底の平らな部分の径 | Ø170mm | |
| 高さ | 235mm | パッケージ表記の H224 と合わない |
| 底の肉厚 | 1.1mm | |
| テーパー（片側） | 約 4.9° | 旧記録の値は 4.865° |
| 重さ | 228g | 旧記録では「実測の例」として引かれていたが、手元の個体を量ったかは記録からはっきりしない。量り直す |

参考: 対象を空き缶（直径 65mm、仮の値）とすると、中心からのずれの許容は (210 − 65) / 2 = **72.5mm** になる。
縁にかかって入る分や跳ね出す分は入っていない。トライアル 02 で実際に落として決める。
