f18c052f/smart-trashbox-trial/trials/01-circuit/kicad/mobile-base/mobile-base.kicad_pcb

## KiCad design otomatik-tarla-sulama-sistemi.kicad_sch


Parts:
12V_AKU: Battery
BUCK_1_5V, BUCK_2_MODEM: Conn_01x04
C1: 1000uF
D1: LED_BAGLANTI
D2: LED_VANA
D3: LED_GUC
Debimetre: Conn_01x03
ESP32_BESLEME: Conn_01x02
INA219-akım/voltaj-olcer: Conn_01x06
L298N-vana-surucu: Conn_01x13
Nem-sensoru-1, Nem-sensoru-2: Conn_01x03
R1: 4.7k
R2, R4, R5, R6, R7, R8, R9: 10k
R3: 20k
R10, R11, R12: 220
SW1: BUTON
Sicaklik-sensoru: DS18B20; TO-92_Inline
U1: ESP32-WROOM-32
modem-4G: Conn_01x06
vana-1, vana-2: Conn_01x02

Connections:
+3V3: Nem-sensoru-1.1, R1.1, Sicaklik-sensoru.3 (V_{DD}), U1.2 (VDD)
DS18B20_DQ: R1.2, Sicaklik-sensoru.2 (DQ), U1.26 (IO4)
GND: Nem-sensoru-1.3, Sicaklik-sensoru.1 (GND), U1.1 (GND), U1.15 (GND), U1.38 (GND), U1.39 (GND)
NEM1_AOUT: Nem-sensoru-1.2, U1.8 (IO32)
