f18c052f/smart-trashbox-trial/(commit log)

2026-11-05 Add KiCad project for trial 01 circuit
    Schematic-only project (no PCB; built on perfboard) under
    trials/01-circuit/kicad/mobile-base/, plus .gitignore for KiCad
    artifacts and CLAUDE.md with repo conventions.
    [mobile-base.kicad_pcb, mobile-base.kicad_sch]
2026-11-05 Add schematic stages to trial plan 01
2026-11-05 Add circuit decision-making guidance to CLAUDE.md
